RADARC/M0ZSU_TG/README.md

# M0ZSU_TG

Homebrew tracking generator for HP 8558B Spectrum Analyser.
