RADARC/M0ZSU_TG/KiCAD/TrackingGenerator.kicad_pcb

## KiCad design KiCAD/TrackingGenerator.kicad_pcb (2022-01-25)

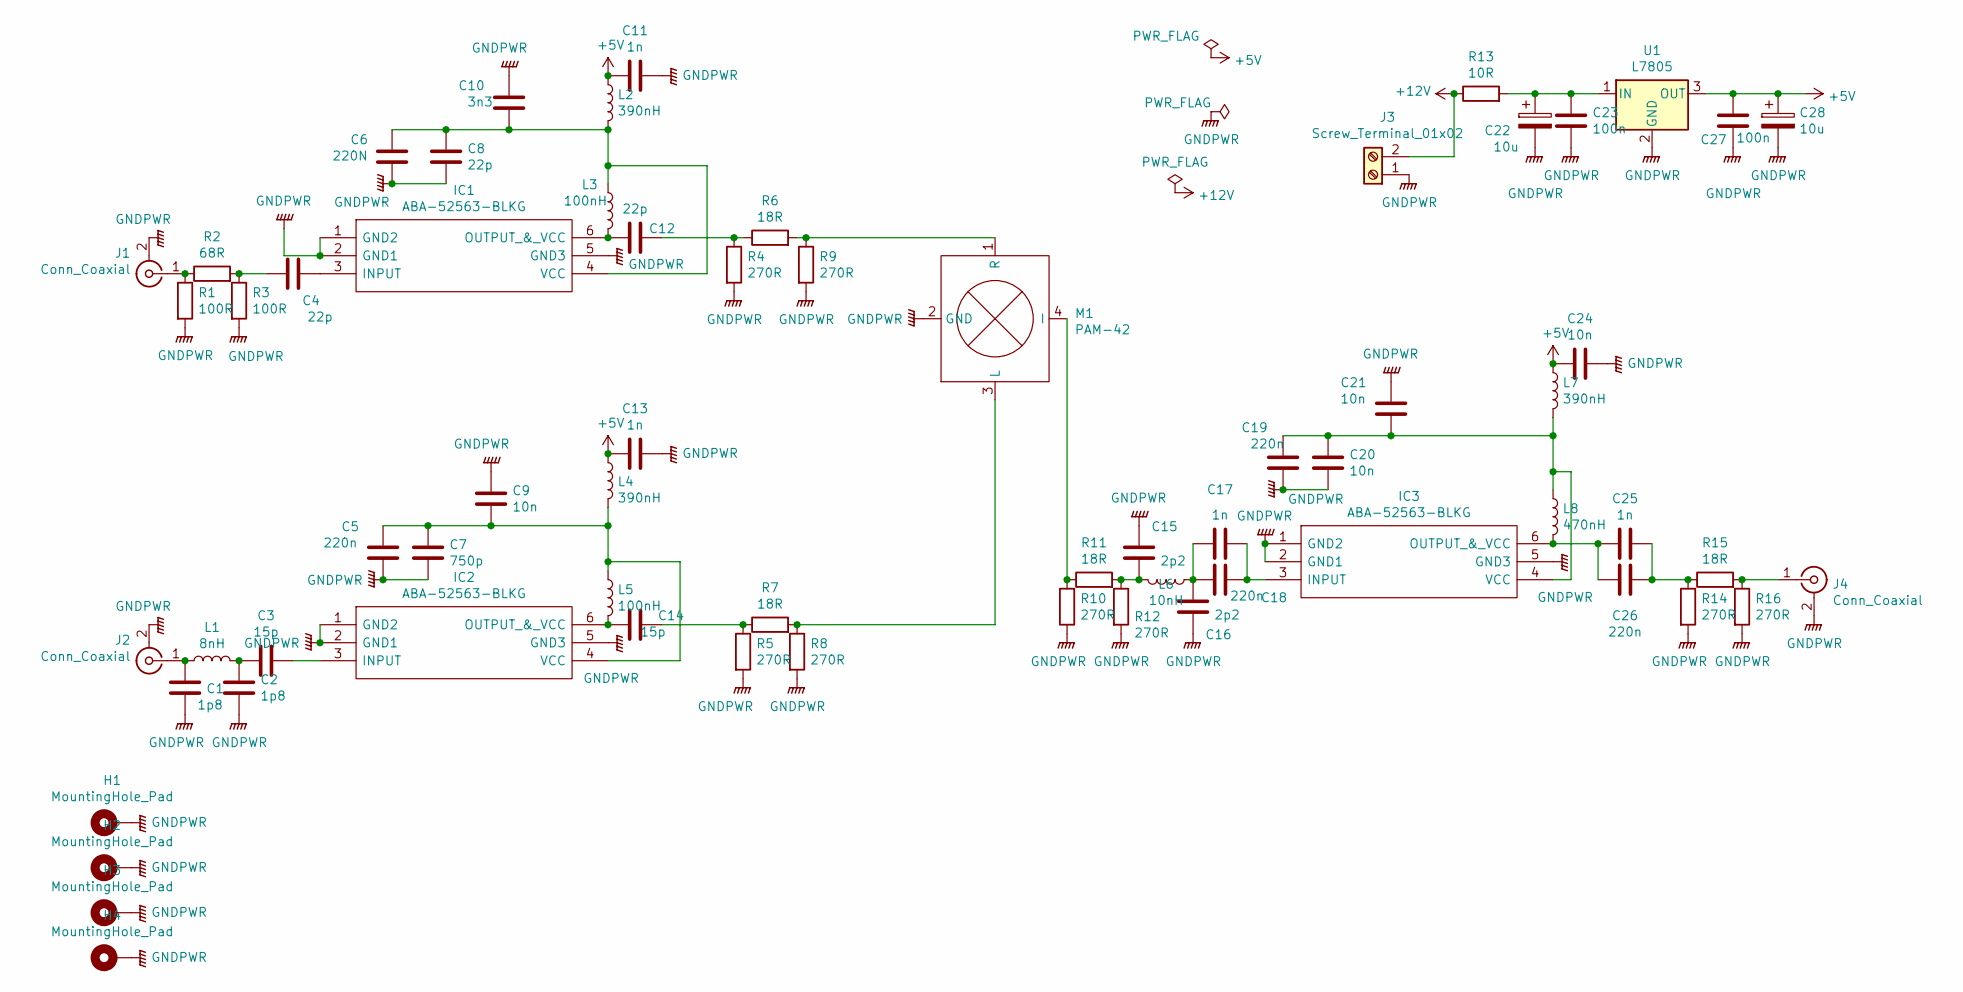
[picture p1: schematic TrackingGenerator.kicad_sch]

Parts:
C1, C2: 1p8; C_0603_1608Metric_Pad1.08x0.95mm_HandSolder
C3, C14: 15p; C_0603_1608Metric_Pad1.08x0.95mm_HandSolder
C4, C8, C12: 22p; C_0603_1608Metric_Pad1.08x0.95mm_HandSolder
C5, C18, C19, C26: 220n; C_0603_1608Metric_Pad1.08x0.95mm_HandSolder
C6: 220N; C_0603_1608Metric_Pad1.08x0.95mm_HandSolder
C7: 750p; C_0603_1608Metric_Pad1.08x0.95mm_HandSolder
C9, C20, C21, C24: 10n; C_0603_1608Metric_Pad1.08x0.95mm_HandSolder
C10: 3n3; C_0603_1608Metric_Pad1.08x0.95mm_HandSolder
C11, C13, C17, C25: 1n; C_0603_1608Metric_Pad1.08x0.95mm_HandSolder
C15, C16: 2p2; C_0603_1608Metric_Pad1.08x0.95mm_HandSolder
C22, C28: 10u; CP_Radial_D6.3mm_P2.50mm
C23, C27: 100n; C_0603_1608Metric_Pad1.08x0.95mm_HandSolder
H1, H2, H3, H4: MountingHole_Pad; MountingHole_3.2mm_M3_DIN965
IC1, IC2, IC3: ABA-52563-BLKG; SOT65P210X110-6N; Manufacturer_Part_Number ABA-52563-BLKG; Mouser Part Number 630-ABA-52563-BLKG
J1, J2, J4: Conn_Coaxial; SMA_Amphenol_132289_EdgeMount
J3: Screw_Terminal_01x02; TerminalBlock_TE_282834-2_1x02_P2.54mm_Horizontal
L1: 8nH; L_0603_1608Metric_Pad1.05x0.95mm_HandSolder
L2, L4, L7: 390nH; L_0603_1608Metric_Pad1.05x0.95mm_HandSolder
L3, L5: 100nH; L_0603_1608Metric_Pad1.05x0.95mm_HandSolder
L6: 10nH; L_0603_1608Metric_Pad1.05x0.95mm_HandSolder
L8: 470nH; L_0603_1608Metric_Pad1.05x0.95mm_HandSolder
M1: PAM-42; PAM42
R1, R3: 100R; R_0603_1608Metric_Pad0.98x0.95mm_HandSolder
R2: 68R; R_0603_1608Metric_Pad0.98x0.95mm_HandSolder
R4, R5, R8, R9, R10, R12, R14, R16: 270R; R_0603_1608Metric_Pad0.98x0.95mm_HandSolder
R6, R7, R11, R15: 18R; R_0603_1608Metric_Pad0.98x0.95mm_HandSolder
R13: 10R; R_Axial_DIN0411_L9.9mm_D3.6mm_P25.40mm_Horizontal
U1: L7805; TO-220-3_Vertical

Connections:
+5V: C11.1, C13.2, C24.2, C27.1, C28.1, L2.1, L4.1, L7.1, U1.3 (OUT)
+12V: J3.2, R13.1
GNDPWR: C1.2, C2.2, C5.2, C6.2, C7.2, C8.2, C9.1, C10.1, C11.2, C13.1, C15.1, C16.2, C19.2, C20.2, C21.1, C22.2, C23.2, C24.1, C27.2, C28.2, H1.1, H2.1, H3.1, H4.1, IC1.1 (GND2), IC1.2 (GND1), IC1.5 (GND3), IC2.1 (GND2), IC2.2 (GND1), IC2.5 (GND3), IC3.1 (GND2), IC3.2 (GND1), IC3.5 (GND3), J1.2 (Ext), J2.2 (Ext), J3.1, J4.2 (Ext), M1.2 (GND), R1.2, R3.2, R4.2, R5.2, R8.2, R9.2, R10.1, R12.2, R14.2, R16.2, U1.2 (GND)
unnamed: C1.1, J2.1 (In), L1.1
unnamed: C2.1, C3.1, L1.2
unnamed: C3.2, IC2.3 (INPUT)
unnamed: C4.1, R2.2, R3.1
unnamed: C4.2, IC1.3 (INPUT)
unnamed: C5.1, C7.1, C9.2, IC2.4 (VCC), L4.2, L5.1
unnamed: C6.1, C8.1, C10.2, IC1.4 (VCC), L2.2, L3.1
unnamed: C12.1, R4.1, R6.1
unnamed: C12.2, IC1.6 (OUTPUT_&_VCC), L3.2
unnamed: C14.1, IC2.6 (OUTPUT_&_VCC), L5.2
unnamed: C14.2, R5.1, R7.1
unnamed: C15.2, L6.2, R11.2, R12.1
unnamed: C16.1, C17.1, C18.1, L6.1
unnamed: C17.2, C18.2, IC3.3 (INPUT)
unnamed: C19.1, C20.1, C21.2, IC3.4 (VCC), L7.2, L8.1
unnamed: C22.1, C23.1, R13.2, U1.1 (IN)
unnamed: C25.1, C26.1, IC3.6 (OUTPUT_&_VCC), L8.2
unnamed: C25.2, C26.2, R14.1, R15.1
unnamed: J1.1 (In), R1.1, R2.1
unnamed: J4.1 (In), R15.2, R16.1
unnamed: M1.1 (R), R6.2, R9.1
unnamed: M1.3 (L), R7.2, R8.1
unnamed: M1.4 (I), R10.2, R11.1

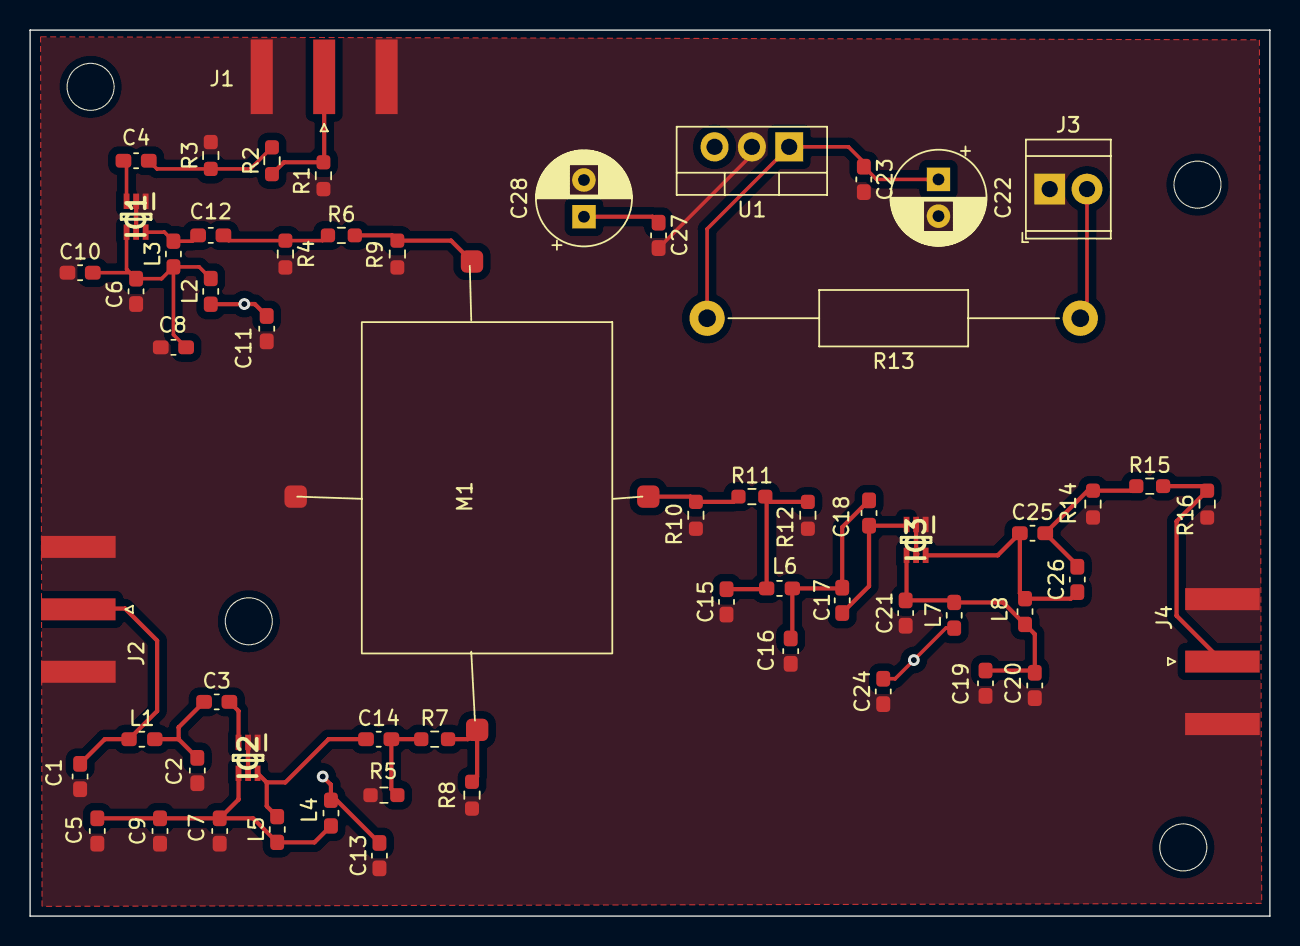
[picture p2: board TrackingGenerator.kicad_pcb from above]

Board: 4 copper layers, 84.4 x 60.3 mm, 65 parts (0 on the bottom side), 26 nets.
