RADARC/M0ZSU_TG/(commit log)

2022-01-18 Added KiCad files
    Added KiCad files initial.
    [TrackingGenerator.kicad_pcb, TrackingGenerator.kicad_sch, test.kicad_pcb, test.kicad_sch]
2022-01-21 Changes to use LC7628 stackup
    [TrackingGenerator.kicad_pcb]
2022-01-21 More routing work
    [TrackingGenerator.kicad_pcb, TrackingGenerator.kicad_sch]
2022-01-25 Add more routing
    [TrackingGenerator.kicad_pcb]
2022-01-25 Further updates
    [TrackingGenerator.kicad_pcb]
